grubisuperman/NixieClock/resources/readme.md

# Inbetriebnahmeanleitung zur NixieUhr				29.12.2019 
* Netzteil erst mit der Steckdose verbinden und dann erst mit der Uhr, um Bootprobleme zu vermeiden.
* Prüfen, ob das Wifi-Netzwerk  *NixieClockTwo* verfügbar ist. Die Uhr sollte 00:00:00 anzeigen.
* Andernfalls muss die Nixieuhr geöffnet werden. Den Druckschgalten S1_Config (rechts) gedrückt halten und die Uhr mit dem Strom verbinden.  
* Verbinden mit dem Wifi-Netzwerk *NixieClockTwo*, Passwort *PasswordNixie*
* Browser öffen. Man sollte automatisch auf der Konfigurationsseite landen. Alternativ im Browser die Adresse http://192.168.4.1 aufrufen.
* Auf der Auswahlseite *Configure WiFi* wählen.
* Gewünschtes WiFi-Netzwerk anwählen und passwort eingeben.
* Sobald sich die Uhr erfolgreich mit Wifi verbunden hat, wird die aktuelle Verbindung automatisch getrennt. Die Uhr sollte die aktuelle Uhrzeit anzeigen. Anderemfalls wird eine Statusseite eingeblendet und die Eingabe muss wiederholt werden.
* Die Uhr ist jetzt im lokalen Netzwerk unter http://nixieclocktwo im Browser erreichbar und erlaubt weitere Einstellungen.
