grubisuperman/NixieClock/eagle/Nixie HV Switching PSU/Warenkorb_Mrz25_0215.xls

WARENKORB
Dies ist keine Rechnung
25-Mrz-18 14:15:00
 | Mouser-Nr. | Herst.- Nr. | Hersteller | Kunden-Teilenr | Beschreibung | RoHS | Lebenszyklus | Stückzahl | Preis (EUR) | Gesamtpreis: (EUR)
1 | 871-B82479A1104M | B82479A1104M | EPCOS / TDK | R2512 | Festinduktivitäten 100uH 1.8A 20 % 18.54x15.24mm SMD | RoHS-konform |  | 10 | 1,34 € | 13,40 €
2 | 700-MAX1771ESA | MAX1771ESA+ | Maxim Integrated |  | Schaltregler 12/Adj V Low IQ Step-Up | RoHS-konform |  | 10 | 5,86 € | 58,60 €
3 | 581-TPSD107M020R0085 | TPSD107M020R0085 | AVX |  | Tantalkondensatoren - fest für SMD 100UF 20V 20% 7343-31 | RoHS-konform |  | 10 | 0,992 € | 9,92 €
4 | 667-EEV-EB2E100Q | EEV-EB2E100Q | Panasonic |  | Alu-Elektrolytkondensatoren - SMD 10UF 250V ELECT EB SMD | RoHS-konform |  | 10 | 1,08 € | 10,80 €
5 | 581-TPSD106K035R0300 | TPSD106K035R0300 | AVX |  | Tantalkondensatoren - fest für SMD 10uF 35V 10% L ESR | RoHS-konform |  | 10 | 0,82 € | 8,20 €
6 | 844-IRF644PBF | IRF644PBF | Vishay |  | MOSFET N-Chan 250V 14 Amp | RoHS: Konform durch Ausnahmegenehmigung |  | 10 | 0,976 € | 9,76 €
Durch das Absenden Ihrer Bestellung erklären Sie sich mit diesen Geschäftsbedingungen einverstanden. (https://www.mouser.de/saleterms) |  |  |  |  |  |  |  |  | Gesamtwarenkosten: | 110,68 €
Die Preise sind zum angezeigten Datum und zur Uhrzeit reflektiert. |  |  |  |  |  |  |  |  | Versandkosten: | 0,00 €
