grubisuperman/NixieClock/cad/Gehaeuse_IN12_Rueckwand_V2.stl

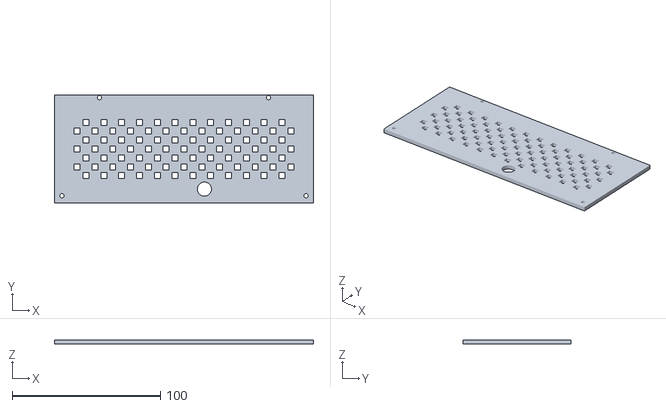
[picture p1: CAD file, 2019-12-31]
cad/Gehaeuse_IN12_Rueckwand_V2.stl
174.5 x 73.0 x 3.00
