grubisuperman/NixieClock/cad/Gehaeuse_IN12.stl

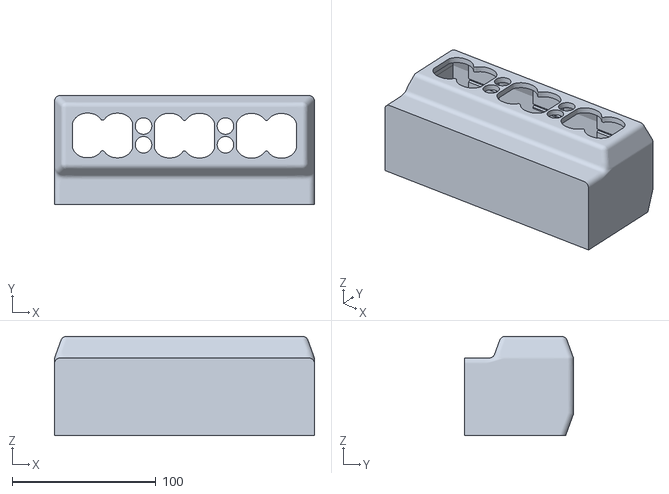
[picture p2: CAD file, 2019-12-31]
cad/Gehaeuse_IN12.stl
180.9 x 75.9 x 69.0
