grubisuperman/NixieClock/cad/Gehaeuse_IN12_V2.stl

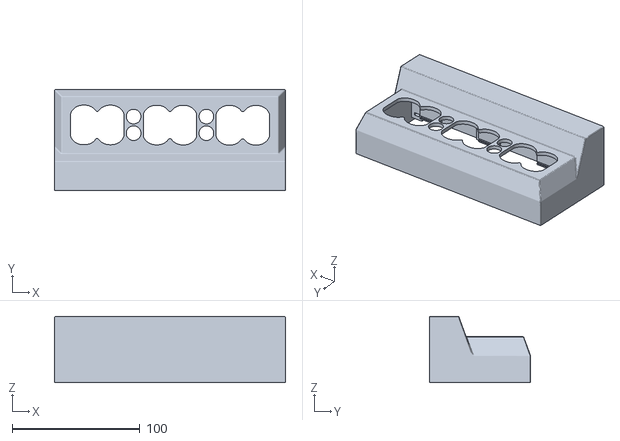
[picture p3: CAD file, 2019-12-31]
cad/Gehaeuse_IN12_V2.stl
180.9 x 79.3 x 52.0
