grubisuperman/NixieClock/cad/Gehaeuse_IN12_Rueckwand.stl

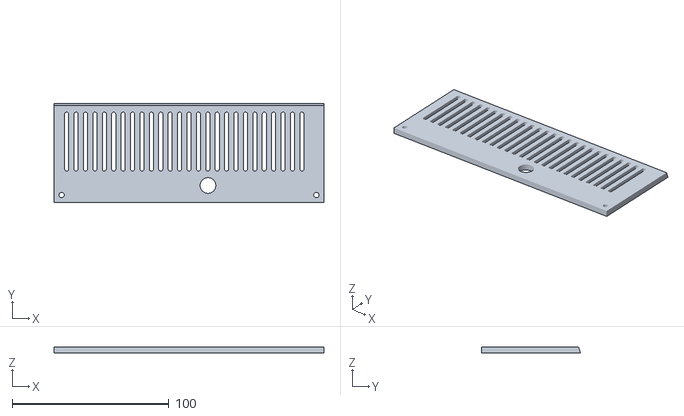
[picture p4: CAD file, 2019-12-31]
cad/Gehaeuse_IN12_Rueckwand.stl
172.2 x 63.5 x 4.00
