grubisuperman/NixieClock/cad/Gehaeuse_IN12_V1.stl

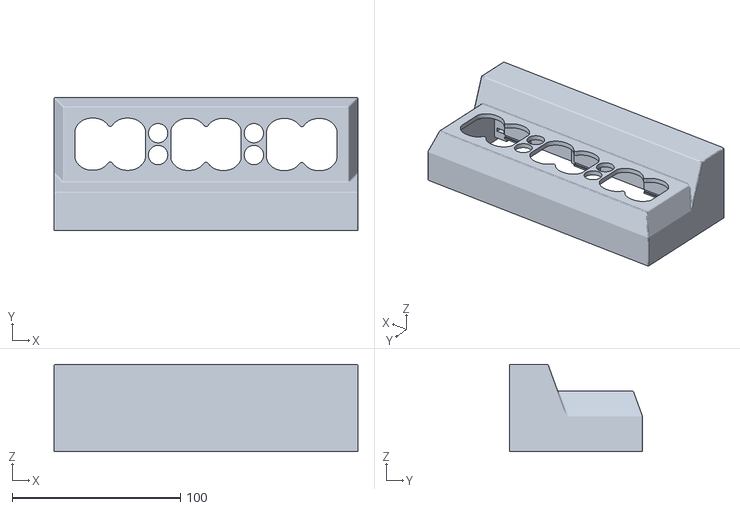
[picture p5: CAD file, 2019-12-31, an earlier design]
cad/Gehaeuse_IN12_V1.stl
180.9 x 79.3 x 52.0
