grubisuperman/NixieClock/(list of files, cad)

Other CAD files:
cad/Gehaeuse_IN12_Rueckwand_V1.stl
cad/Gehaeuse_IN12.ipt
cad/Gehaeuse_IN12_Fassung.ipt
cad/Gehaeuse_IN12_Rueckwand.ipt
cad/Gehaeuse_IN12_Rueckwand_V1.1.ipt
cad/Gehaeuse_IN12_V1.1.ipt
cad/IN-12_Nixie_Board.iam
cad/IN-12_Nixie_Board_Zusammenbau.iam
cad/NixieMainboard.brd.iam
cad/NixieModule_IN12.brd.ipt
cad/Zusammenbau.iam
