grubisuperman/NixieClock/eagle/Nixie HV Switching PSU/MAX 1771 V5 Eagle files/Nixie HV PSU MAX1771.brd

## EAGLE design eagle/Nixie HV Switching PSU/MAX 1771 V5 Eagle files/Nixie HV PSU MAX1771.brd (2019-12-31)

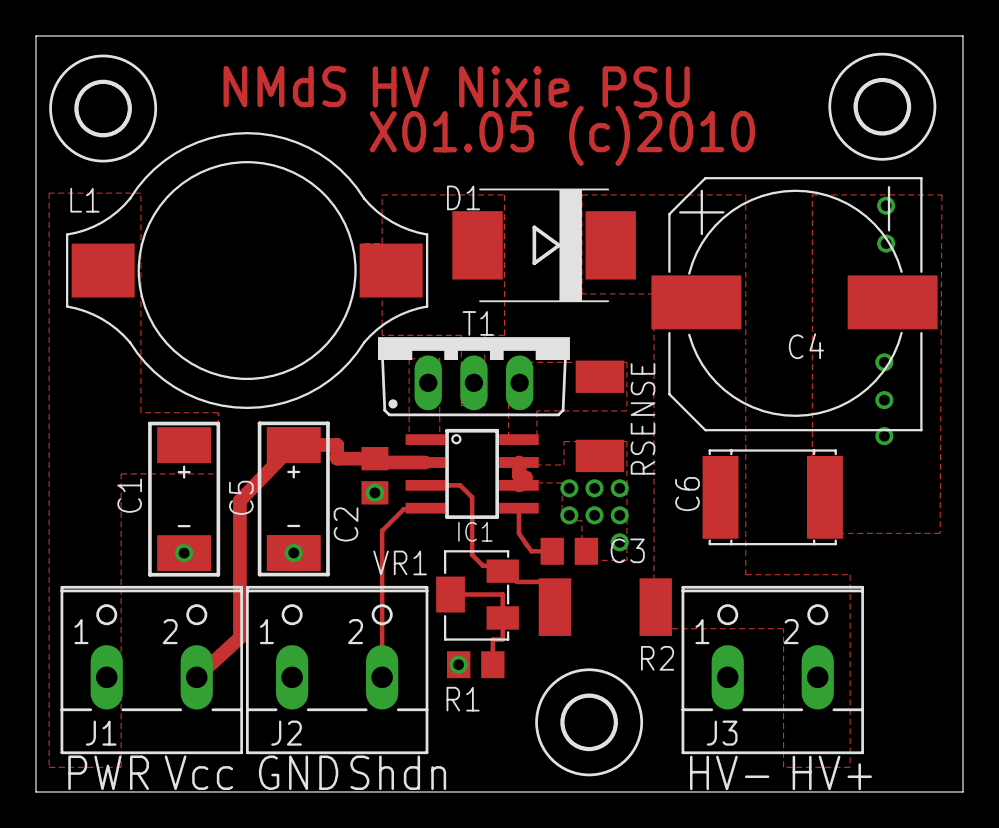
[picture p6: board Nixie HV PSU MAX1771.brd from above]

Board: 2 copper layers, 51.5 x 42.0 mm, 20 parts (0 on the bottom side), 11 nets.

Parts:
C1: 100uF,35V; C-EIA-7343
C2, C3: 100n; C0805
C4: 4u7,250V; NICHICON-UJ-12
C5: 10uF,25V; C-EIA-7343
C6: 100n,250V; C2420
D1: ES2F; SMC
IC1: MAX1771ESA; SO-8
J1, J2, J3: SCREW-2-02
L1: 100uH; L-B82479
R1: 10K; R0805
R2: 1M5; R2512
RSENSE: 0R050; R2010
T1: IRF644PBF; TO220BV
U$2, U$3, U$4: 2,8
VR1: 5K; BOURNS-3214W

Connections:
DGND: C1.-, C2.2, C3.2, C4.1, C5.-, C6.P$2, IC1.6, IC1.7, J2.1, J3.1, R1.1, RSENSE.1
EXT: IC1.1, T1.G
unnamed: IC1.8, RSENSE.2, T1.S
unnamed: R1.2, VR1.1, VR1.2
unnamed: IC1.3, R2.1, VR1.3
unnamed: D1.A, L1.P$2, T1.D
unnamed: C3.1, IC1.5
PWR: C1.+, J1.1, L1.P$1
SHDN: IC1.4, J2.2
VCC: C2.1, C5.+, IC1.2, J1.2
VOUT: C4.2, C6.P$1, D1.C, J3.2, R2.2
