grubisuperman/NixieClock/eagle/NixieModule_IN-12/NixieModule_IN12.brd

## EAGLE design eagle/NixieModule_IN-12/NixieModule_IN12.brd (2019-12-31)

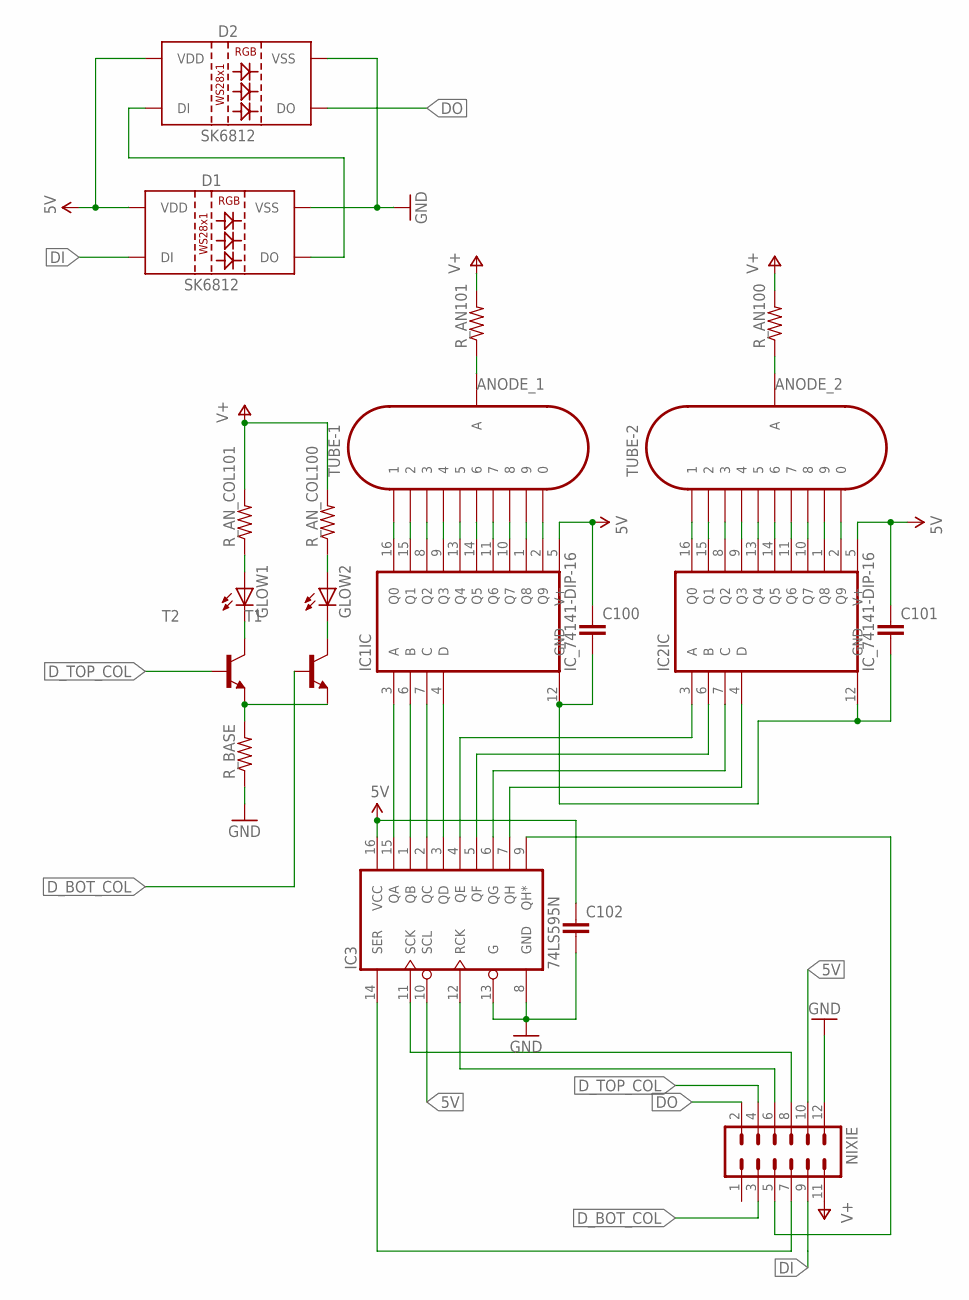
[picture p7: schematic NixieModule_IN12.sch]

Parts:
C100, C101, C102: C-EU050-024X044; C050-024X044
D1, D2: SK6812; WS2812B
GLOW1, GLOW2: LED_ELD260; LED_LD260
IC1, IC2: IC_74141-DIP-16; DIL16
IC3: 74LS595N; DIL16
NIXIE: MA06-2
R_AN100, R_AN101: RESISTORPTH-1/4W; AXIAL-0.4
R_AN_COL100, R_AN_COL101: RESISTORPTH-1/4W; AXIAL-0.4
R_BASE: RESISTORPTH-1/4W; AXIAL-0.4
T1, T2: -NPN-TO92-EBC; TO92-EBC
TUBE-1, TUBE-2: IN-12A; IN-12

Connections:
5V: C100.1, C101.1, C102.1, D1.1 (VDD), D2.1 (VDD), IC1.5 (V+), IC2.5 (V+), IC3.10 (SCL), IC3.16 (VCC), NIXIE.10
ANODE_1: R_AN101.P$1 (1), TUBE-1.A
ANODE_2: R_AN100.P$1 (1), TUBE-2.A
DI: D1.4 (DI), NIXIE.9
DO: D2.2 (DO), NIXIE.2
D_BOT_COL: NIXIE.3, T1.B
D_TOP_COL: NIXIE.4, T2.B
GND: C100.2, C101.2, C102.2, D1.3 (VSS), D2.3 (VSS), IC1.12 (GND), IC2.12 (GND), IC3.8 (GND), IC3.13 (G), NIXIE.12, R_BASE.P$1 (1)
unnamed: GLOW1.A, R_AN_COL101.P$1 (1)
unnamed: GLOW2.A, R_AN_COL100.P$1 (1)
unnamed: GLOW1.K (C), T2.C
unnamed: IC1.16 (Q0), TUBE-1.1
unnamed: IC1.15 (Q1), TUBE-1.2
unnamed: IC1.8 (Q2), TUBE-1.3
unnamed: IC1.9 (Q3), TUBE-1.4
unnamed: IC1.13 (Q4), TUBE-1.5
unnamed: IC1.14 (Q5), TUBE-1.6
unnamed: IC1.11 (Q6), TUBE-1.7
unnamed: IC1.10 (Q7), TUBE-1.8
unnamed: IC1.1 (Q8), TUBE-1.9
unnamed: IC1.2 (Q9), TUBE-1.0
unnamed: GLOW2.K (C), T1.C
unnamed: R_BASE.P$2 (2), T1.E, T2.E
unnamed: IC2.9 (Q3), TUBE-2.4
unnamed: IC2.13 (Q4), TUBE-2.5
unnamed: IC2.14 (Q5), TUBE-2.6
unnamed: IC2.11 (Q6), TUBE-2.7
unnamed: IC2.10 (Q7), TUBE-2.8
unnamed: IC2.1 (Q8), TUBE-2.9
unnamed: IC2.2 (Q9), TUBE-2.0
unnamed: D1.2 (DO), D2.4 (DI)
unnamed: IC1.6 (B), IC3.1 (QB)
unnamed: IC1.7 (C), IC3.2 (QC)
unnamed: IC1.4 (D), IC3.3 (QD)
unnamed: IC1.3 (A), IC3.15 (QA)
unnamed: IC2.3 (A), IC3.4 (QE)
unnamed: IC2.6 (B), IC3.5 (QF)
unnamed: IC2.7 (C), IC3.6 (QG)
unnamed: IC2.4 (D), IC3.7 (QH)
RCK: IC3.12 (RCK), NIXIE.6
SCK: IC3.11 (SCK), NIXIE.8
SERIAL_SHIFT_IN: IC3.14 (SER), NIXIE.7
SERIAL_SHIFT_OUT: IC3.9 (QH*), NIXIE.5
T2_1: IC2.16 (Q0), TUBE-2.1
T2_2: IC2.15 (Q1), TUBE-2.2
T2_3: IC2.8 (Q2), TUBE-2.3
V+: NIXIE.11, R_AN100.P$2 (2), R_AN101.P$2 (2), R_AN_COL100.P$2 (2), R_AN_COL101.P$2 (2)

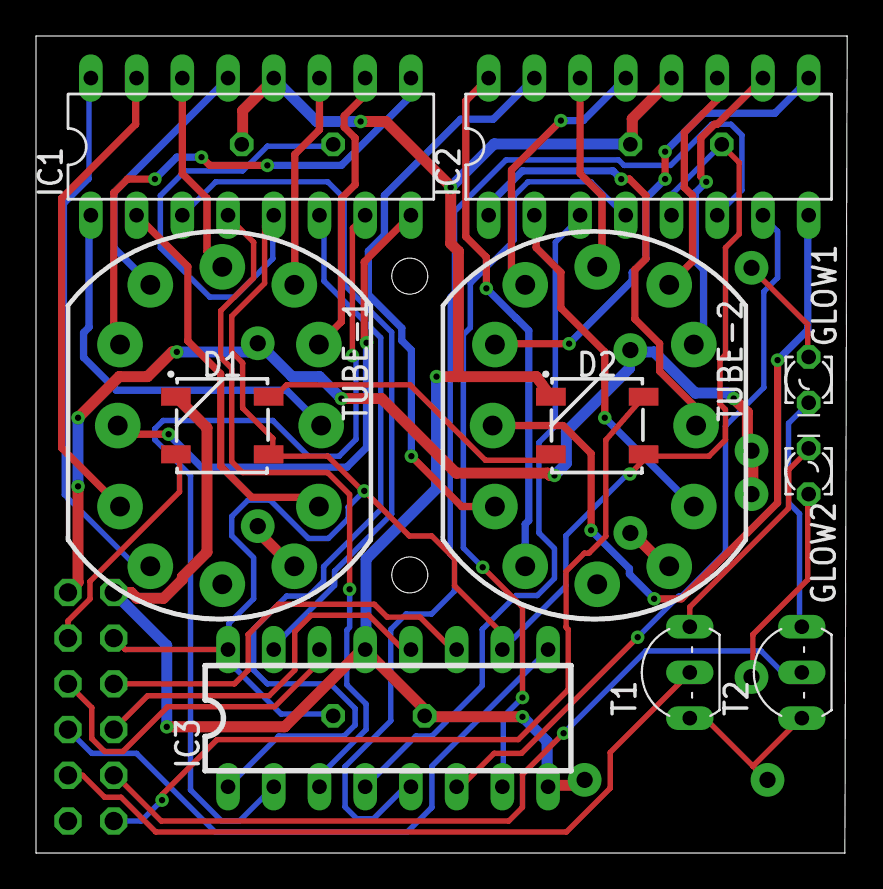
[picture p8: board NixieModule_IN12.brd from above]

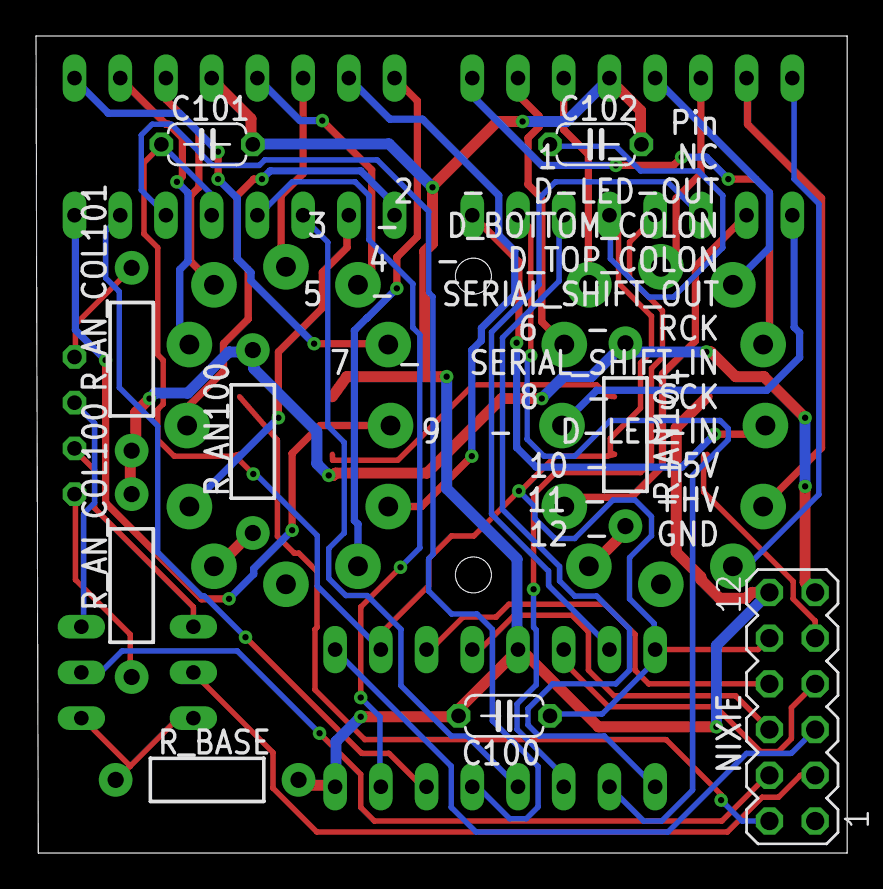
[picture p9: board NixieModule_IN12.brd from below]

Board: 2 copper layers, 45.1 x 45.4 mm, 20 parts (9 on the bottom side), 47 nets.
