grubisuperman/NixieClock/eagle/NixieMainboard_IN-12/NixieMainboard.brd

## EAGLE design eagle/NixieMainboard_IN-12/NixieMainboard.brd (2019-12-31)

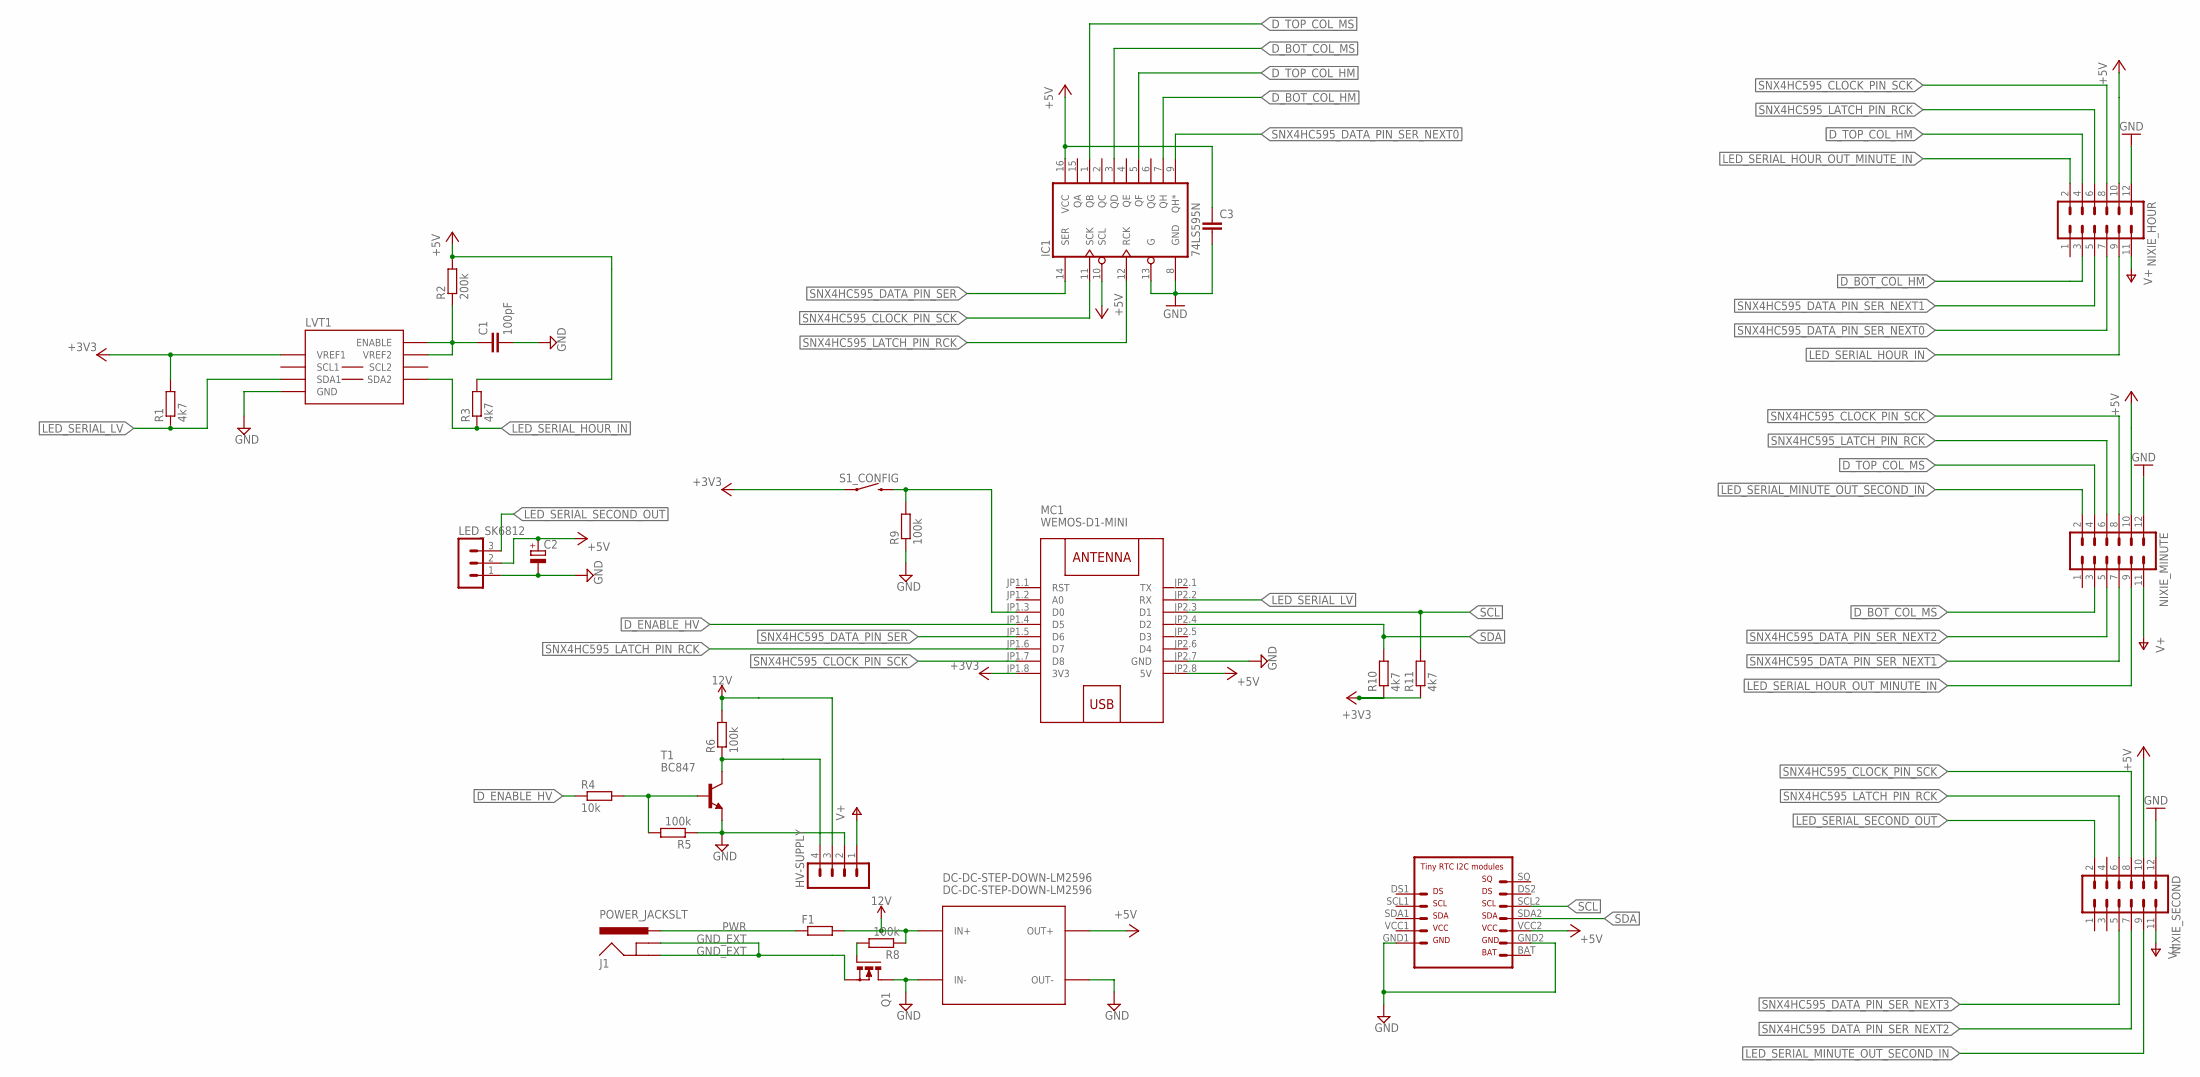
[picture p10: schematic NixieMainboard.sch]

Parts:
C1: 100pF; C0805
C2: CPOL-EUE5-8.5; E5-8,5
C3: C-EU050-024X044; C050-024X044
DC-DC-STEP-DOWN-LM2596: DC-DC-STEP-DOWN-LM2596
F1: R-EU_R2512W; R2512W
HV-SUPPLY: MA04-1
IC1: 74LS595N; DIL16
J1: POWER_JACKSLT; POWER_JACK_SLOT
LED_SK6812: MA03-1
LVT1: IC2_LEVEL_TRANSLATER; SOIC-8
MC1: WEMOS-D1-MINI
NIXIE_HOUR: MA06-2
NIXIE_MINUTE: MA06-2
NIXIE_SECOND: MA06-2
Q1: PMOSFET_NTO220BV; TO220BV
R1, R3, R10, R11: 4k7; R0805
R2: 200k; R0805
R4: 10k; R0805
R5, R6, R8, R9: 100k; R0805
RTC1: RTC
S1_CONFIG: MOMENTARY-SWITCH-SPST-PTH-6.0MM; TACTILE_SWITCH_PTH_6.0MM
T1: BC847; SOT23

Connections:
12V: DC-DC-STEP-DOWN-LM2596.IN+, F1.2, HV-SUPPLY.3, R6.2, R8.1
+3V3: LVT1.1 (VREF1), MC1.JP1.8 (3V3), R1.2, R10.1, R11.1, S1_CONFIG.1
+5V: C2.+, C3.1, DC-DC-STEP-DOWN-LM2596.OUT+, IC1.10 (SCL), IC1.16 (VCC), LED_SK6812.2, MC1.JP2.8 (5V), NIXIE_HOUR.10, NIXIE_MINUTE.10, NIXIE_SECOND.10, R2.2, R3.2, RTC1.VCC2
D_BOT_COL_HM: IC1.7 (QH), NIXIE_HOUR.3
D_BOT_COL_MS: IC1.3 (QD), NIXIE_MINUTE.3
D_ENABLE_HV: MC1.JP1.4 (D5), R4.1
D_TOP_COL_HM: IC1.5 (QF), NIXIE_HOUR.4
D_TOP_COL_MS: IC1.1 (QB), NIXIE_MINUTE.4
GND: C1.2, C2.-, C3.2, DC-DC-STEP-DOWN-LM2596.IN-, DC-DC-STEP-DOWN-LM2596.OUT-, HV-SUPPLY.2, IC1.8 (GND), IC1.13 (G), LED_SK6812.1, LVT1.4 (GND), MC1.JP2.7 (GND), NIXIE_HOUR.12, NIXIE_MINUTE.12, NIXIE_SECOND.12, Q1.D, R5.1, R9.1, RTC1.GND1, RTC1.GND2, T1.2 (E)
GND_EXT: J1.GND@1 (GNDBREAK), J1.GND@2 (GND), Q1.S
LED_SERIAL_HOUR_IN: LVT1.5 (SDA2), NIXIE_HOUR.9, R3.1
LED_SERIAL_HOUR_OUT_MINUTE_IN: NIXIE_HOUR.2, NIXIE_MINUTE.9
LED_SERIAL_LV: LVT1.3 (SDA1), MC1.JP2.2 (RX), R1.1
LED_SERIAL_MINUTE_OUT_SECOND_IN: NIXIE_MINUTE.2, NIXIE_SECOND.9
LED_SERIAL_SECOND_OUT: LED_SK6812.3, NIXIE_SECOND.2
unnamed: R4.2, R5.2, T1.1 (B)
unnamed: HV-SUPPLY.4, R6.1, T1.3 (C)
unnamed: Q1.G, R8.2
unnamed: MC1.JP1.3 (D0), R9.2, S1_CONFIG.3 (2)
unnamed: C1.1, LVT1.7 (VREF2), LVT1.8 (ENABLE), R2.1
PWR: F1.1, J1.PWR
SCL: MC1.JP2.3 (D1), R11.2, RTC1.SCL2
SDA: MC1.JP2.4 (D2), R10.2, RTC1.SDA2
SNX4HC595_CLOCK_PIN_SCK: IC1.11 (SCK), MC1.JP1.7 (D8), NIXIE_HOUR.8, NIXIE_MINUTE.8, NIXIE_SECOND.8
SNX4HC595_DATA_PIN_SER: IC1.14 (SER), MC1.JP1.5 (D6)
SNX4HC595_DATA_PIN_SER_NEXT0: IC1.9 (QH*), NIXIE_HOUR.7
SNX4HC595_DATA_PIN_SER_NEXT1: NIXIE_HOUR.5, NIXIE_MINUTE.7
SNX4HC595_DATA_PIN_SER_NEXT2: NIXIE_MINUTE.5, NIXIE_SECOND.7
SNX4HC595_DATA_PIN_SER_NEXT3: NIXIE_SECOND.5
SNX4HC595_LATCH_PIN_RCK: IC1.12 (RCK), MC1.JP1.6 (D7), NIXIE_HOUR.6, NIXIE_MINUTE.6, NIXIE_SECOND.6
V+: HV-SUPPLY.1, NIXIE_HOUR.11, NIXIE_MINUTE.11, NIXIE_SECOND.11

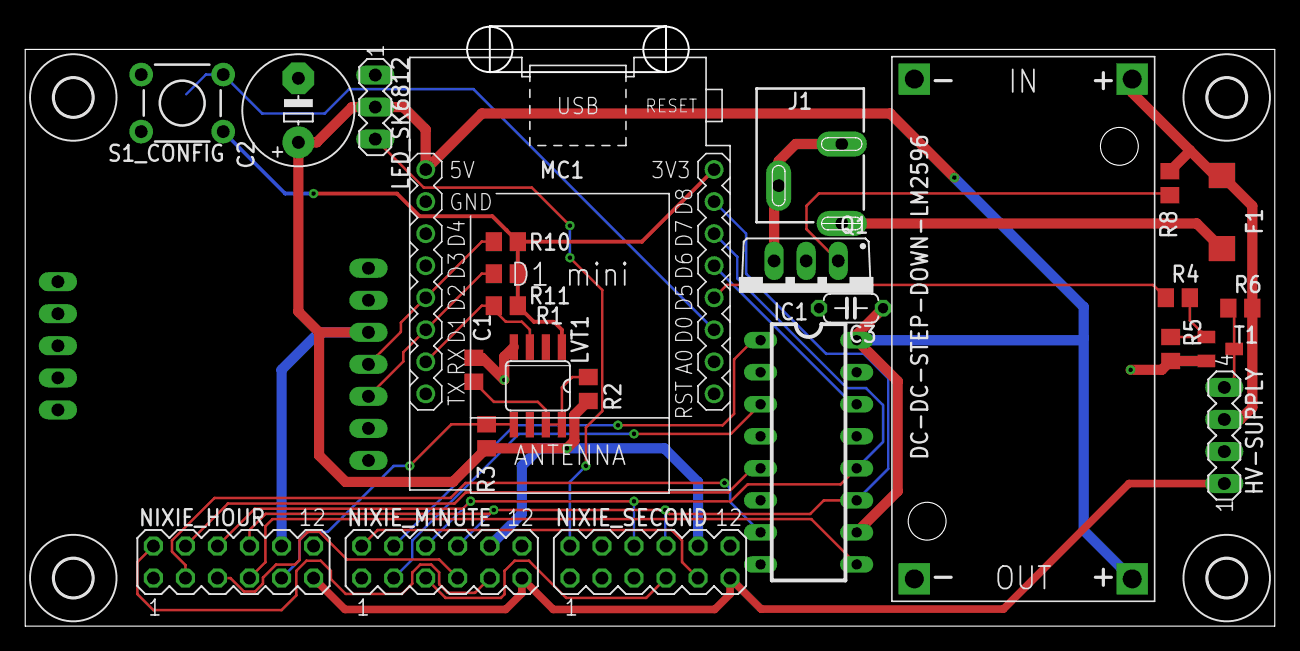
[picture p11: board NixieMainboard.brd from above]

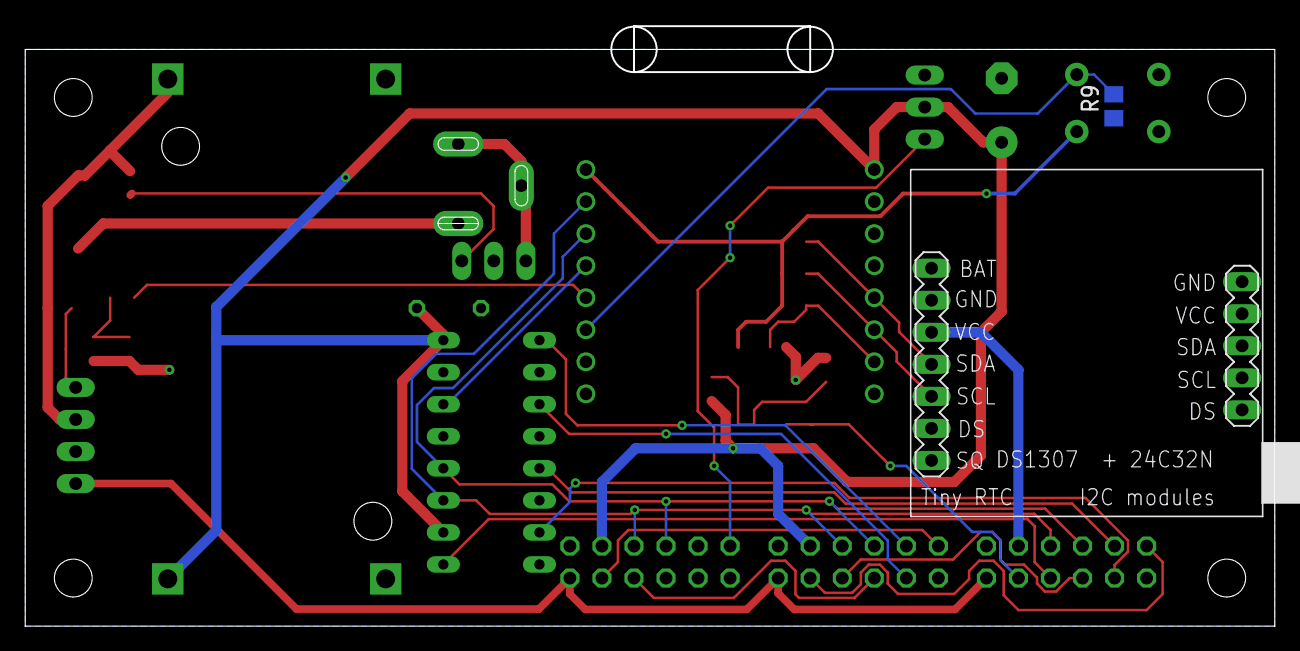
[picture p12: board NixieMainboard.brd from below]

Board: 2 copper layers, 99.1 x 47.6 mm, 32 parts (2 on the bottom side), 30 nets.

Other parts of the board:
U$2, U$3, U$4, U$5: 3,0
