grubisuperman/NixieClock/eagle/NixieModule_IN-14/NixieModule.brd

## EAGLE design eagle/NixieModule_IN-14/NixieModule.brd (2019-12-31)

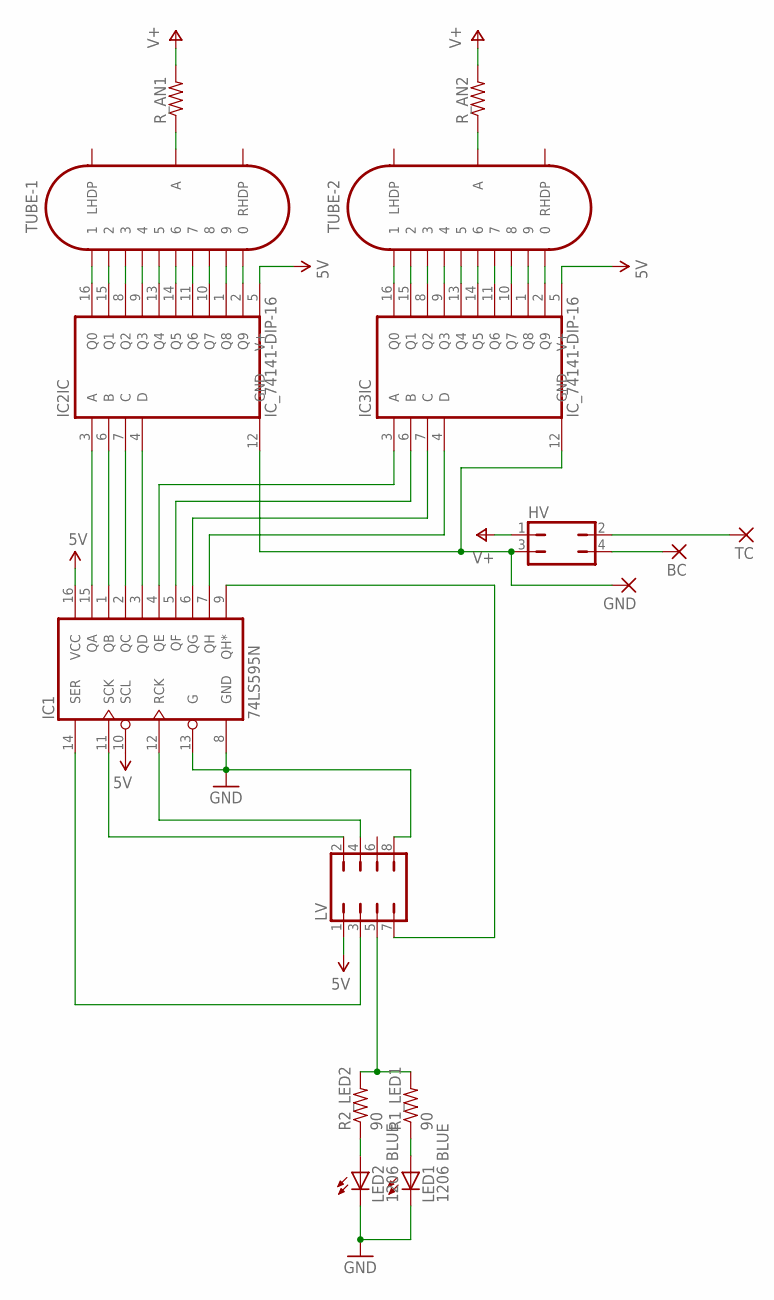
[picture p13: schematic NixieModule.sch]

Parts:
BC: 1,6/0,9
GND: 1,6/0,9
HV: JP2Q
IC1: 74LS595N; DIL16
IC2, IC3: IC_74141-DIP-16; DIL16
LED1, LED2: 1206 BLUE; LED_1206
LV: JP4Q
R1_LED1, R2_LED2: 90; AXIAL-0.4
R_AN1, R_AN2: RESISTORPTH-1/4W; AXIAL-0.4
TC: 1,6/0,9
TUBE-1, TUBE-2: IN-14

Connections:
5V: IC1.16 (VCC), IC2.5 (V+), IC3.5 (V+), LV.1
GND: GND.1, HV.3, IC1.8 (GND), IC1.13 (G), IC2.12 (GND), IC3.12 (GND), LED1.C, LED2.C, LV.8
unnamed: R_AN1.P$1 (1), TUBE-1.A
unnamed: R_AN2.P$1 (1), TUBE-2.A
unnamed: IC1.12 (RCK), LV.4
unnamed: IC1.11 (SCK), LV.2
unnamed: IC1.14 (SER), LV.3
unnamed: LED2.A, R2_LED2.P$1 (1)
unnamed: IC2.16 (Q0), TUBE-1.1
unnamed: IC2.15 (Q1), TUBE-1.2
unnamed: IC2.8 (Q2), TUBE-1.3
unnamed: IC2.9 (Q3), TUBE-1.4
unnamed: IC2.13 (Q4), TUBE-1.5
unnamed: IC2.14 (Q5), TUBE-1.6
unnamed: IC2.11 (Q6), TUBE-1.7
unnamed: IC2.10 (Q7), TUBE-1.8
unnamed: IC2.1 (Q8), TUBE-1.9
unnamed: IC2.2 (Q9), TUBE-1.0
unnamed: IC3.16 (Q0), TUBE-2.1
unnamed: IC3.15 (Q1), TUBE-2.2
unnamed: IC3.8 (Q2), TUBE-2.3
unnamed: IC3.9 (Q3), TUBE-2.4
unnamed: IC3.13 (Q4), TUBE-2.5
unnamed: IC3.14 (Q5), TUBE-2.6
unnamed: IC3.11 (Q6), TUBE-2.7
unnamed: IC3.10 (Q7), TUBE-2.8
unnamed: IC3.1 (Q8), TUBE-2.9
unnamed: IC3.2 (Q9), TUBE-2.0
unnamed: LED1.A, R1_LED1.P$1 (1)
unnamed: LV.5, R1_LED1.P$2 (2), R2_LED2.P$2 (2)
unnamed: HV.2, TC.1
unnamed: BC.1, HV.4
unnamed: IC1.1 (QB), IC2.6 (B)
unnamed: IC1.2 (QC), IC2.7 (C)
unnamed: IC1.3 (QD), IC2.4 (D)
unnamed: IC1.15 (QA), IC2.3 (A)
unnamed: IC1.4 (QE), IC3.3 (A)
unnamed: IC1.5 (QF), IC3.6 (B)
unnamed: IC1.6 (QG), IC3.7 (C)
unnamed: IC1.7 (QH), IC3.4 (D)
unnamed: IC1.9 (QH*), LV.7
V+: HV.1, R_AN1.P$2 (2), R_AN2.P$2 (2)
VCC: IC1.10 (SCL)

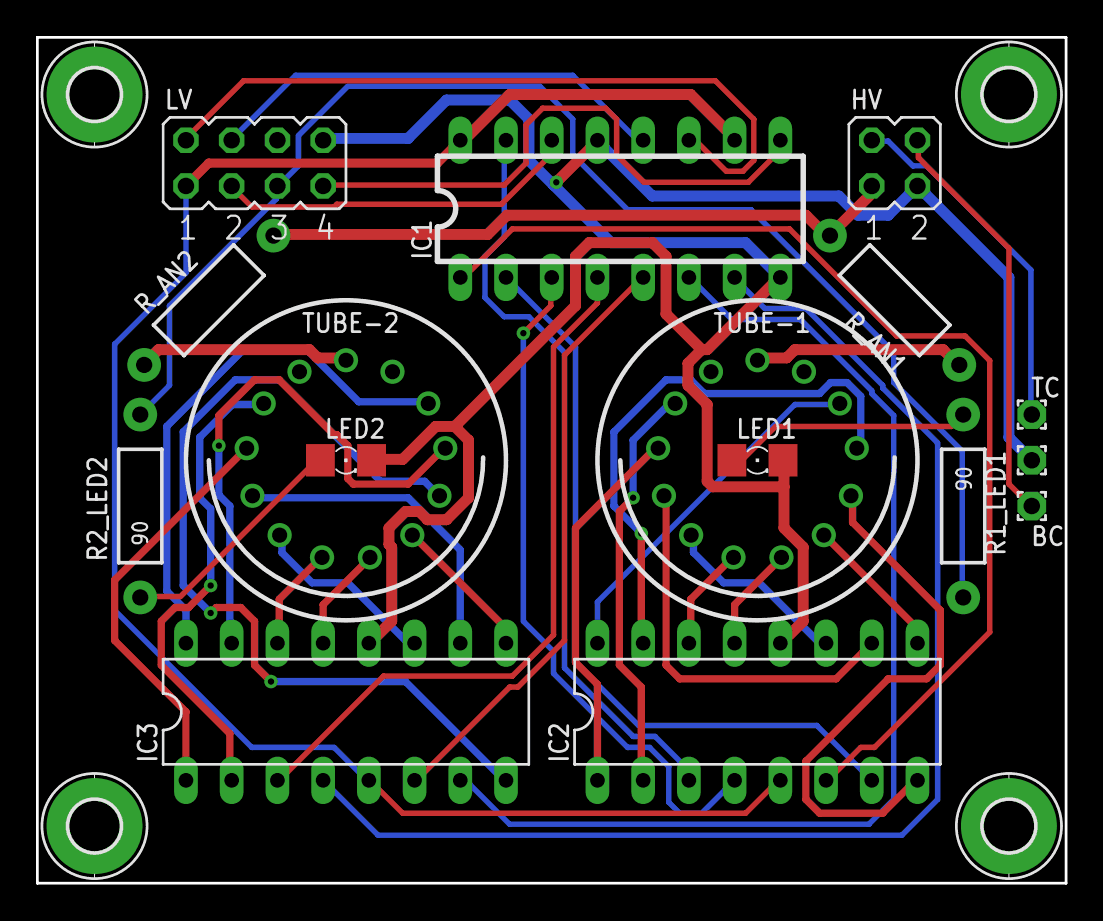
[picture p14: board NixieModule.brd from above]

Board: 2 copper layers, 57.1 x 47.0 mm, 20 parts (0 on the bottom side), 42 nets.

Other parts of the board:
H1, H2, H3, H4: MOUNT-PAD-ROUND2.8; 2,8-PAD
