grubisuperman/NixieClock/(notices)

Notices in the files:
eagle/Nixie HV Switching PSU/MAX 1771 V5 Eagle files/Nixie HV PSU MAX1771.brd:
(c)2010
parts and their libraries:
SparkFun: Licensing: CC v3.0 Share-Alike You are welcome to use this library for commercial purposes.
diy-modules: Released under the Creative Commons Attribution 4.0 International License: http://creativecommons.org/licenses/by/4.0
